hiltonml/pinball/Eckerd_Themed_Machine.jpg

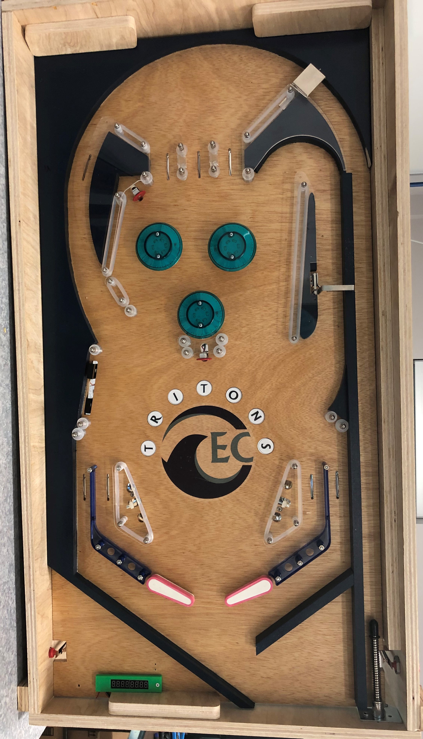
Eckerd_Themed_Machine.jpg
