hiltonml/pinball/02_Pinball Assembly Instructions.docx

Pinball Assembly Instructions

This document contains information about how various mechanicals should be attached to the playfield. It is not an exhaustive set of instructions. When the order of assembly is important, numbered steps will be provided; otherwise, bullets will be used.

It is assumed that the playfield and wood extrusions have already been painted and decorated.

Initial Steps

The order of the initial steps is important. We want to determine if any modifications to the playfield or wood extrusions need to be made before we start attaching too many of the mechanisms.

1. Attach to the top of the playfield all mechanisms that require cutouts in the wood extrusions, such as one-way ball gates and spinners.
2. Attach the wooden extrusions to the playfield. Modify the extrusions as necessary to fit over the parts attached in Step 1.
3. Attach the posts required for elastic bands. Test fit the elastic bands. If a band is too loose, add another post inside the band and position it to stretch the band to the desired tension. Mark the position of the new post, drill a 1/8" hole though the playfield at that position, and attach the new post to the playfield.
4. Remove the elastic bands for now, so they do not get in the way.
5. Each pop bumper has three long nail-shaped screws that need to be nailed through the top surface of the playfield. You must support the playfield adequately while you are nailing, or it will crack.
6. Mount the playfield in its cradle and secure it in place.
7. Attach the return lane guides.

Attach the Mechanisms

The mechanisms can be attached in any order that you wish. For most of the mechanisms, use #8 × 1/2" screws to attach the mechanism to the bottom of the playfield. The only intricate installation is the pop bumpers, described below.

Pop Bumper Assembly

Pop bumpers have a lot of parts that need to be attached in the correct order. Here is a video showing how the various parts fit together: https://youtu.be/5YjmaDIFFCo

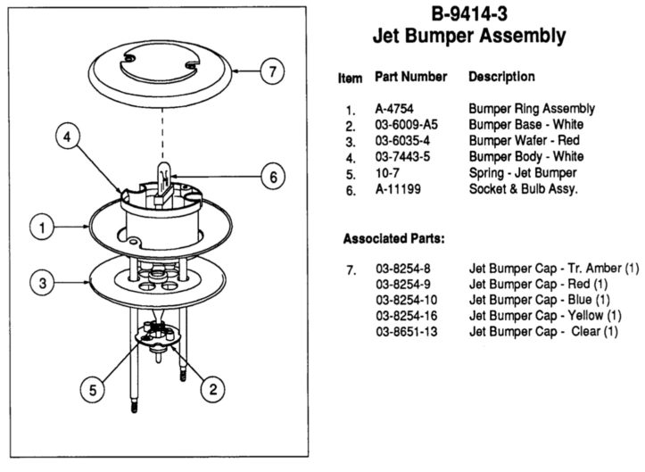
[picture p6: figure]
Shop Your Pinball Machine - Part 5 - Removing the Pop Bumpers -

1. You should have already nailed the three large screws through the playfield. Attach the solenoid assembly using those three screws and nylon insert lock nuts.
2. If Part #7, the Bumper Cap, is screwed to the bumper body, unscrew it and set the parts aside.
3. Remove Part #6, the Socket & Bulb Assembly, from the bumper body.
4. Insert Part #2, the Bumper Base, in the central hole on the top of the playfield. The bumper base must be oriented so two (opposing) semi-circular cutouts are aligned with the two satellite holes and the tall screw posts are located over the screw holes in the playfield.
5. Place the spring into the center depression of the bumper base.
6. Insert Part #3, the Bumper Wafer, through the center hole of the bumper base.
7. Align Part #4, the Bumper Body, with the tall screw posts in the bumper base. Affix the bumper body using the supplied screws.
8. Insert Part #1, the Bumper Ring Assembly, over the bumper body and through the bumper wafer and the two satellite holes. Screw the ring assembly to the solenoid assembly.
9. Thread the wire leads on the socket & bulb assembly through the holes in the bumper body and on through the playfield.
10. If you are including a BrightCaps EVO bumper lighting module, now is the time to install it.
11. Attach the bumper cap to the bumper base.

Part Identification Guide

1-Bank Drop Target Assembly

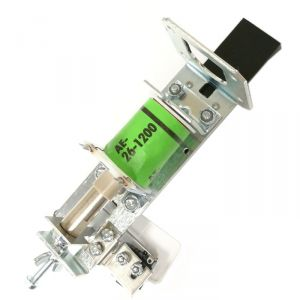
[picture p7: figure]
1-Bank Drop Target Assembly

EVO Bright-Caps Bumper Lighting

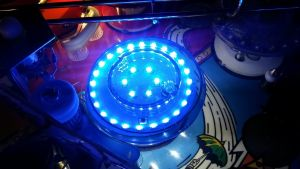
[picture p8: figure]
BriteCaps EVO Pop Bumper Lighting

Finned Star Post

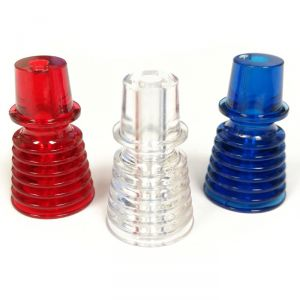
[picture p9: figure]
Finned Post - 1-3/16"

Flipper Assembly (note there are left and right assemblies)

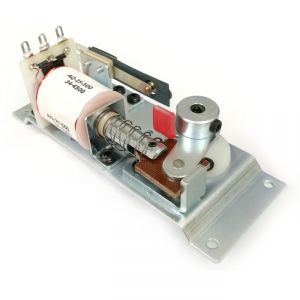
[picture p10: figure]
Full Flipper Assembly For Classic Bally Machines 05/1975 To 04/1980

Flipper Bat

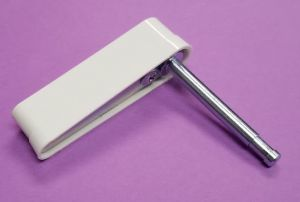
[picture p11: figure]
Classic Bally Shoe and Shaft Flipper Bat Assembly

One-Way Ball Gate (note there are left- and right-hand gates)

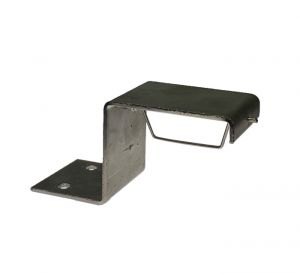
[picture p12: figure]
Brunswick One-Way Ball Gate Assembly - Left

Narrow Plastic Post

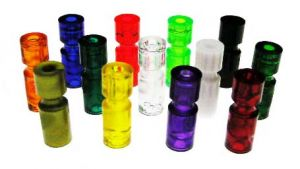
[picture p13: figure]
Data East/Sega/Stern Narrow Plastic Post 1-1/16" Tall

Pop Bumper Assembly

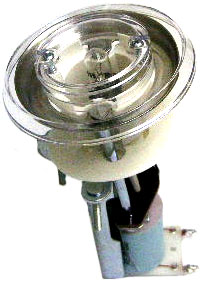
[picture p14: figure]
Williams/Bally Pop Bumper Assembly

Return Lane Guide

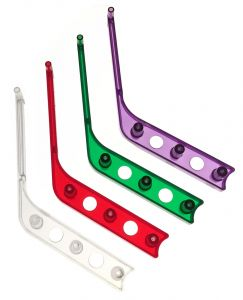
[picture p15: figure]
Data East/Sega/Stern Return Lane Guide

Rollover Switch Assembly

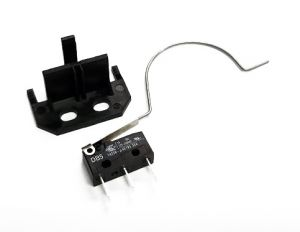
[picture p16: figure]
Rollover Switch With Mounting Bracket

Shooter Assembly

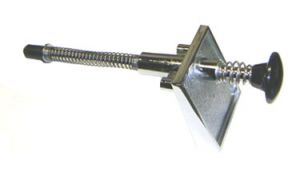
[picture p17: figure]
Williams/Bally Ball Shooter Assembly

Slingshot Assembly

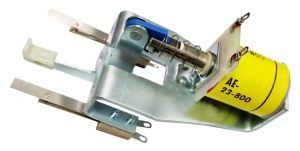
[picture p18: figure]
Slingshot Assembly

Spinner Assembly

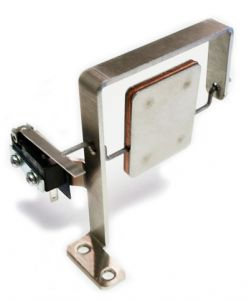
[picture p19: figure]
Complete Spinner Assembly With Switch (Left Side)

Stand-Up Target

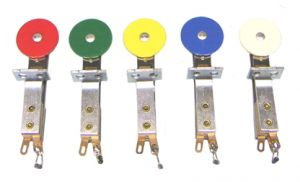
[picture p20: figure]
Williams/Bally Round Stand-Up Targets
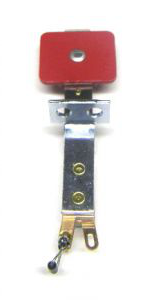
[picture p21: figure]
Williams/Bally Red Rectangle Stand-up Target
