hiltonml/pinball/Code/Software_Tailored_for_Eckerd_Themed_Machine/main_scoring/main_scoring.ino

/*
 * Code for Pinball Scoring Arduino
 * Mike Hilton, Eckerd College
 * 
 * This program implements the scoring functions
 * for the NA125 STEM course pinball machine.
 */

// If DEBUG is defined, debug messages will be printed to the serial monitor.  
#define DEBUG

#include "main_scoring.h"

#include "Debounce.h"

#include <Wire.h>
#define I2C_SOLENOID_ADDRESS 8    // solenoid nano
#define I2C_DISPLAY_ADDRESS 9     // display nano

// default values are used if no values are defined in main_scoring.h
#define DefaultScore 5            // number of points scored per switch activation
#define DefaultDelay 4            // debounce delay for switches (milliseconds)  
#define DefaultIgnoreWindow 40    // state change ignore window for switches (milliseconds)


/* 
 *  Defines for the 12 Opto-Isolated Switches
 */

#ifdef Switch1
#define Mask1   B00000010            // I/O pin D9,  Port B, pin 12 on Nano
Debounce *switch1;                   // debounced switch; state() = 1 if pressed, 0 if not pressed
// debounce delay for switch (milliseconds)
#ifndef Delay1
#define Delay1 DefaultDelay                        
#endif
// state change ignore window for switch (milliseconds)
#ifndef IgnoreWindow1
#define IgnoreWindow1 DefaultIgnoreWindow                
#endif
// score for this switch
#ifndef Score1
#define Score1 DefaultScore
#endif
#endif // Switch1

#ifdef Switch2
#define Mask2   B00000100          // I/O pin D10,  Port B, pin 13 on Nano
Debounce *switch2;                 // debounced switch; state() = 1 if pressed, 0 if not pressed
// debounce delay for switch (milliseconds)
#ifndef Delay2
#define Delay2 DefaultDelay                         
#endif
// state change ignore window for switch (milliseconds)
#ifndef IgnoreWindow2
#define IgnoreWindow2 DefaultIgnoreWindow                
#endif
// score for this switch
#ifndef Score2
#define Score2 DefaultScore
#endif
#endif // Switch2

#ifdef Switch3
#define Mask3   B00001000          // I/O pin D11,  Port B, pin 14 on Nano
Debounce *switch3;                 // debounced switch; state() = 1 if pressed, 0 if not pressed
// debounce delay for switch (milliseconds)
#ifndef Delay3
#define Delay3 DefaultDelay                         
#endif
// state change ignore window for switch (milliseconds)
#ifndef IgnoreWindow3
#define IgnoreWindow3 DefaultIgnoreWindow                
#endif
// score for this switch
#ifndef Score3
#define Score3 DefaultScore
#endif
#endif // Switch3

#ifdef Switch4
#define Mask4   B00010000          // I/O pin D12,  Port B, pin 15 on Nano
Debounce *switch4;                 // debounced switch; state() = 1 if pressed, 0 if not pressed
// debounce delay for switch (milliseconds)
#ifndef Delay4
#define Delay4 DefaultDelay                         
#endif
// state change ignore window for switch (milliseconds)
#ifndef IgnoreWindow4
#define IgnoreWindow4 DefaultIgnoreWindow                
#endif
// score for this switch
#ifndef Score4
#define Score4 DefaultScore
#endif
#endif // Switch4

#ifdef Switch5
#define Mask5   B00000001          // I/O pin A0,   Port C, pin 19 on Nano
Debounce *switch5;                 // debounced switch; state() = 1 if pressed, 0 if not pressed
// debounce delay for switch (milliseconds)
#ifndef Delay5
#define Delay5 DefaultDelay                         
#endif
// state change ignore window for switch (milliseconds)
#ifndef IgnoreWindow5
#define IgnoreWindow5 DefaultIgnoreWindow                
#endif
// score for this switch
#ifndef Score5
#define Score5 DefaultScore
#endif
#endif // Switch5

#ifdef Switch6
#define Mask6   B00000010          // I/O pin A1,   Port C, pin 20 on Nano
Debounce *switch6;                 // debounced switch; state() = 1 if pressed, 0 if not pressed
// debounce delay for switch (milliseconds)
#ifndef Delay6
#define Delay6 DefaultDelay                         
#endif
// state change ignore window for switch (milliseconds)
#ifndef IgnoreWindow6
#define IgnoreWindow6 DefaultIgnoreWindow                
#endif
// score for this switch
#ifndef Score6
#define Score6 DefaultScore
#endif
#endif // Switch6

#ifdef Switch7
#define Mask7   B00000100          // I/O pin A2,   Port C, pin 21 on Nano
Debounce *switch7;                 // debounced switch; state() = 1 if pressed, 0 if not pressed
// debounce delay for switch (milliseconds)
#ifndef Delay7
#define Delay7 DefaultDelay                         
#endif
// state change ignore window for switch (milliseconds)
#ifndef IgnoreWindow7
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
// 1 if pressed, 0 if not
int solenoid1, solenoid2, solenoid3, solenoid4;
int solenoid5, solenoid6, solenoid7, solenoid8;


////// Global variables associated with scoring
long int score = 0;       // current score
long int lastScore = 0;   // last score sent to display nano

////// Global variables associated with lighting routine
int lightingID = 0;       // ID code sent to display nano
int lastLightingID = 0;   // last lighting ID sent to display nano
int lightingChangeTime = 0;   // time of last change in lighting routine

////// Global variables associated with sound routine
int soundID = 0;          // ID code sent to display nano 

void setup() {
  setupSwitches();

  // initialize I2C communications
  Wire.begin();
  
#ifdef DEBUG
  Serial.begin(9600);
  Serial.println("Initialized");
#endif  
}


void loop() {
  readSwitches();
  readSolenoidData();

#ifdef DEBUG
  writeSwitchesToSerial(); 
#endif

  handleSwitches(); 
  handleSolenoidSwitches();
  
  handleLighting();
  
  if ((lastScore != score) || (lastLightingID != lightingID) || (soundID != 0)) {
    sendDisplayPacket();
    soundID = 0;
  }
}


// Handle state details associated with changing the lighting ID
void changeLighting(int newID) {
    lastLightingID = lightingID;
    lightingID = newID;
    lightingChangeTime = millis();
}


// Lighting state machine
void handleLighting() {

  // reset any states that have expired
  if ((lightingID == 1) && (millis() - lightingChangeTime > 5e3)) {
    changeLighting(0);
  }
  
  // Standup target activated
  if (switch7->state()) {
    changeLighting(1);
    soundID = 6;
  }
}

void handleSolenoidSwitches() {
#ifdef Solenoid1
  if (solenoid1) {
    score += SolenoidScore1;
  }
#endif
#ifdef Solenoid2
  if (solenoid2) {
    score += SolenoidScore2;
  }
#endif
#ifdef Solenoid3
  if (solenoid3) {
    score += SolenoidScore3;
  }
#endif
#ifdef Solenoid4
  if (solenoid4) {
    score += SolenoidScore4;
  }
#endif
#ifdef Solenoid5
  if (solenoid5) {
    score += SolenoidScore5;
  }
#endif
#ifdef Solenoid6
  if (solenoid6) {
    score += SolenoidScore6;
    soundID = 1;
  }
#endif
#ifdef Solenoid7
  if (solenoid7) {
    score += SolenoidScore7;
    soundID = 1;
  }
#endif
#ifdef Solenoid8
  if (solenoid8) {
    score += SolenoidScore8;
  }
#endif
}


void handleSwitches() {
#ifdef Switch1  
  if (switch1->state() && !switch1->serviced) {
    score += Score1;
    switch1->serviced = true;
  }
#endif
#ifdef Switch2  
  if (switch2->state() && !switch2->serviced) {
    score += Score2;
    switch2->serviced = true;
  }
#endif
#ifdef Switch3  
  if (switch3->state() && !switch3->serviced) {
    score += Score3;
    switch3->serviced = true;
  }
#endif
#ifdef Switch4  
  if (switch4->state() && !switch4->serviced) {
    score += Score4;
    switch4->serviced = true;
  }
#endif
#ifdef Switch5  
  if (switch5->state() && !switch5->serviced) {
    score += Score5;
    switch5->serviced = true;
  }
#endif
#ifdef Switch6  
  if (switch6->state() && !switch6->serviced) {
    score += Score6;
    switch6->serviced = true;
  }
#endif
#ifdef Switch7  
  if (switch7->state() && !switch7->serviced) {
    score += Score7;
    switch7->serviced = true;
  }
#endif
#ifdef Switch8  
  if (switch8->state() && !switch8->serviced) {
    score += Score8;
    switch8->serviced = true;
  }
#endif
#ifdef Switch9  
  if (switch9->state() && !switch9->serviced) {
    score += Score9;
    switch9->serviced = true;
    soundID = 5;
  }
#endif
#ifdef Switch10  
  if (switch10->state() && !switch10->serviced) {
    score += Score10;
    switch10->serviced = true;
    soundID = 4;
  }
#endif
#ifdef Switch11  
  if (switch11->state() && !switch11->serviced) {
    score += Score11;
    switch11->serviced = true;
    soundID = 2;
  }
#endif
#ifdef Switch12  
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
#ifdef Solenoid6
  if (solenoid6) s = s + " " + Solenoid6;
#endif
#ifdef Solenoid7
  if (solenoid7) s = s + " " + Solenoid7;
#endif
#ifdef Solenoid8
  if (solenoid8) s = s + " " + Solenoid8;
#endif


  if (previous != s) {
#ifdef DEBUG    
    Serial.println(s);
#endif    
  }
  previous = s;
}
